Firebird1029/enas344-final/(list of files, cad)

Other CAD files:
box/final_cardboard_box.dwg
