Firebird1029/enas344-final/v2.5/v2.5.ino

#include <Adafruit_GFX.h>
#include <Adafruit_MPU6050.h>
#include <Adafruit_SSD1306.h>
#include <Adafruit_Sensor.h>
#include <Audio.h>
#include <Bounce2.h>
#include <Encoder.h>
#include <SD.h>
#include <SPI.h>
#include <SerialFlash.h>
#include <Wire.h>

// Konrad's custom delay line code
#include "effect_delayLoop.h"

// GENERAL

// 1 measure @ 100 bpm (1 quarter note = 600 ms)
// 1 measure = 4 quarter notes = 4 * 600 ms = 2400 ms
#define LOOP_TIME 2400

// 44100 samples/sec * 10 sec = 441000
// 44100 samples/sec * 3 sec = 132300
// should be as long/longer than LOOP_TIME
#define DELAYLINE_MAX_LEN 132300

#define MASTER_VOLUME 0.5  // <= 0.8 to prevent distortion

// menu encoder sensitivity (how many encoder ticks to change to next menu item)
#define MES 10

#define BASE_FREQ 349.23  // F4, default tonic
// FUTURE: allow option to change tonic

// lower value = faster rate; slower rate prevents value ramping issue
#define RIBBON_POT_CHECK_RATE 5

// default envelope values
#define DEFAULT_ENV_ATTACK 10.5
#define DEFAULT_ENV_HOLD 2.5
#define DEFAULT_ENV_DECAY 35
#define DEFAULT_ENV_SUSTAIN 0.8
#define DEFAULT_ENV_RELEASE 300

#define CHIPTUNE_FREQ_MOD 6.0
#define CHIPTUNE_AMP_PER_SEMITONE (1.f / (CHIPTUNE_FREQ_MOD * 12))
// Explanation: 1 octave has 12 semitones. If amplitude of DC object into FM is
// 1.0, then pitch is 6 octaves higher. So, the amplitude of the DC object to
// get 1 semitone higher should be the above.

// PINOUT

#define ENCODER_DT_PIN 3
#define ENCODER_CLK_PIN 4  // reverse DT & CLK for counterclockwise
#define ENCODER_BTN_PIN 2
#define RIBBON_POT_PIN_1 41  // A17
#define RIBBON_POT_PIN_2 40  // A16
// #define LOOP_BTN_PIN 32
// #define COMMIT_BTN_PIN 31
// #define CLEAR_BTN_PIN 30

// OLED

#define SCREEN_WIDTH 128
#define SCREEN_HEIGHT 32
#define OLED_RESET_PIN -1
#define SCREEN_ADDRESS 0x3C

// MOTION

#define MOTION_ALPHA 0.5  // 0 = acceleration, 1 = gyro, default: 0.995

// use basic_readings_calib to determine IMU calibration values, otherwise
// values will drift

#define ACCELX_OFF 0.295
#define ACCELY_OFF 0.08
#define ACCELZ_OFF -0.2

#define GYROX_OFF -0.1197
#define GYROY_OFF -0.0157
#define GYROZ_OFF -0.0190

#define ACCELX_SCALE 1.008
#define ACCELY_SCALE 1.00
#define ACCELZ_SCALE 0.98

#define GYROX_SCALE 1
#define GYROY_SCALE 1
#define GYROZ_SCALE 1

// AUDIO
EXTMEM int16_t DELAY_LINE_TEMP[DELAYLINE_MAX_LEN] = {};
EXTMEM int16_t DELAY_LINE_FULL_1[DELAYLINE_MAX_LEN] = {};
EXTMEM int16_t DELAY_LINE_FULL_2[DELAYLINE_MAX_LEN] = {};
EXTMEM int16_t DELAY_LINE_FULL_3[DELAYLINE_MAX_LEN] = {};
EXTMEM int16_t DELAY_LINE_FULL_4[DELAYLINE_MAX_LEN] = {};

// CUSTOM GUItool OVERRIDES
AudioEffectdelayLoop tempDelay;   // xy=607,182
AudioEffectdelayLoop fullDelay1;  // xy=868,201
AudioEffectdelayLoop fullDelay2;  // xy=868,201
AudioEffectdelayLoop fullDelay3;  // xy=868,201
AudioEffectdelayLoop fullDelay4;  // xy=868,201

// use pjrc.txt to get/store original (unformatted) GUItool auto-generated code

// GUItool: begin automatically generated code
AudioSynthWaveformDc chipDC;                // xy=55.5,583
AudioPlaySdRaw sdDrum1;                     // xy=58.5,701
AudioPlaySdRaw sdDrum2;                     // xy=58.5,738
AudioSynthWaveform chord2fm;                // xy=59.5,499
AudioPlaySdRaw sdDrum3;                     // xy=58.5,776
AudioSynthWaveform chord3fm;                // xy=60.5,539
AudioSynthSimpleDrum drumSynth;             // xy=64.5,661
AudioSynthWaveform inWaveformFM;            // xy=77.5,401
AudioSynthWaveformDc inRamp;                // xy=120.5,298
AudioSynthWaveformModulated inWaveformMod;  // xy=191.5,452
AudioSynthWaveformModulated chipWave;       // xy=196.5,590
AudioSynthWaveformModulated chord3wave;     // xy=201.5,545
AudioSynthWaveformModulated chord2wave;     // xy=205.5,506
AudioMixer4 modeSelect;                     // xy=219.5,80
AudioEffectMultiply multiply1;              // xy=252.5,325
AudioMixer4 drumMixer;                      // xy=314.5,715
AudioMixer4 inMixer;                        // xy=335.5,177
AudioEffectEnvelope chipEnv;                // xy=335.5,590
AudioEffectEnvelope chord3env;              // xy=351.5,545
AudioSynthSimpleDrum metronome;             // xy=354.5,28
AudioEffectEnvelope chord2env;              // xy=353.5,506
AudioSynthSimpleDrum notification;          // xy=364.5,65
AudioEffectEnvelope inEnvelope;             // xy=363.5,453
AudioMixer4 tempDelayMixer;                 // xy=457.5,302
AudioMixer4 overlayMixer;                   // xy=519.5,54
AudioMixer4 chordMixer;                     // xy=528.5,502
// AudioEffectDelay         tempDelay;      //xy=607.5,182
AudioAmplifier fullDelay2Amp;              // xy=672.5,352
AudioAmplifier fullDelay1Amp;              // xy=678.5,286
AudioSynthWaveformSine outLadderFreqSine;  // xy=681.5,89
AudioMixer4 outMixer;                      // xy=712.5,35
AudioAmplifier fullDelay4Amp;              // xy=715.5,596
AudioAmplifier fullDelay3Amp;              // xy=722.5,466
AudioSynthWaveformDc fullRamp;             // xy=773.5,134
AudioMixer4 fullDelay1Mixer;               // xy=847.5,292
AudioMixer4 fullDelay2Mixer;               // xy=849.5,363
AudioMixer4 fullDelay3Mixer;               // xy=852.5,522
AudioMixer4 fullDelay4Mixer;               // xy=853.5,648
AudioFilterLadder outLadder;               // xy=880.5,30
AudioEffectMultiply multiply2;             // xy=892.5,167
AudioAmplifier outAmp;                     // xy=997.5,75
// AudioEffectDelay         fullDelay1;     //xy=1000.5,292
// AudioEffectDelay         fullDelay2;     //xy=1000.5,420
// AudioEffectDelay         fullDelay3;     //xy=1000.5,549
// AudioEffectDelay         fullDelay4;     //xy=1001.5,677
AudioMixer4 delaySelectNew;               // xy=1076.5,161
AudioOutputI2S i2s1;                      // xy=1120.5,31
AudioSynthWaveformDc delaySelectOldRamp;  // xy=1177,337
AudioSynthWaveformDc delaySelectNewRamp;  // xy=1187,246
AudioEffectMultiply multiply3;            // xy=1275,287
AudioEffectMultiply multiply4;            // xy=1278,369
AudioMixer4 delaySelectOld;               // xy=1294,444
AudioMixer4 delayOutMixer;                // xy=1308,165
AudioConnection patchCord1(chipDC, 0, chipWave, 0);
AudioConnection patchCord2(sdDrum1, 0, drumMixer, 1);
AudioConnection patchCord3(sdDrum2, 0, drumMixer, 2);
AudioConnection patchCord4(chord2fm, 0, chord2wave, 0);
AudioConnection patchCord5(sdDrum3, 0, drumMixer, 3);
AudioConnection patchCord6(chord3fm, 0, chord3wave, 0);
AudioConnection patchCord7(drumSynth, 0, drumMixer, 0);
AudioConnection patchCord8(inWaveformFM, 0, inWaveformMod, 0);
AudioConnection patchCord9(inRamp, 0, multiply1, 0);
AudioConnection patchCord10(inWaveformMod, inEnvelope);
AudioConnection patchCord11(chipWave, chipEnv);
AudioConnection patchCord12(chord3wave, chord3env);
AudioConnection patchCord13(chord2wave, chord2env);
AudioConnection patchCord14(modeSelect, 0, inMixer, 0);
AudioConnection patchCord15(multiply1, 0, tempDelayMixer, 1);
AudioConnection patchCord16(drumMixer, 0, modeSelect, 3);
AudioConnection patchCord17(drumMixer, 0, inMixer, 1);
AudioConnection patchCord18(inMixer, 0, outMixer, 0);
AudioConnection patchCord19(inMixer, 0, multiply1, 1);
AudioConnection patchCord20(chipEnv, 0, modeSelect, 1);
AudioConnection patchCord21(chord3env, 0, chordMixer, 2);
AudioConnection patchCord22(metronome, 0, overlayMixer, 0);
AudioConnection patchCord23(chord2env, 0, chordMixer, 1);
AudioConnection patchCord24(notification, 0, overlayMixer, 1);
AudioConnection patchCord25(inEnvelope, 0, modeSelect, 0);
AudioConnection patchCord26(inEnvelope, 0, chordMixer, 0);
AudioConnection patchCord27(tempDelayMixer, tempDelay);
AudioConnection patchCord28(overlayMixer, 0, outMixer, 3);
AudioConnection patchCord29(chordMixer, 0, modeSelect, 2);
AudioConnection patchCord30(tempDelay, 0, tempDelayMixer, 0);
AudioConnection patchCord31(tempDelay, 0, outMixer, 2);
AudioConnection patchCord32(tempDelay, 0, multiply2, 1);
AudioConnection patchCord33(fullDelay2Amp, 0, fullDelay2Mixer, 1);
AudioConnection patchCord34(fullDelay1Amp, 0, fullDelay1Mixer, 1);
AudioConnection patchCord35(outLadderFreqSine, 0, outLadder, 1);
AudioConnection patchCord36(outMixer, 0, outLadder, 0);
AudioConnection patchCord37(fullDelay4Amp, 0, fullDelay4Mixer, 1);
AudioConnection patchCord38(fullDelay3Amp, 0, fullDelay3Mixer, 1);
AudioConnection patchCord39(fullRamp, 0, multiply2, 0);
AudioConnection patchCord40(fullDelay1Mixer, fullDelay1);
AudioConnection patchCord41(fullDelay2Mixer, fullDelay2);
AudioConnection patchCord42(fullDelay3Mixer, fullDelay3);
AudioConnection patchCord43(fullDelay4Mixer, fullDelay4);
AudioConnection patchCord44(outLadder, outAmp);
AudioConnection patchCord45(multiply2, fullDelay1Amp);
AudioConnection patchCord46(multiply2, fullDelay2Amp);
AudioConnection patchCord47(multiply2, fullDelay3Amp);
AudioConnection patchCord48(multiply2, fullDelay4Amp);
AudioConnection patchCord49(outAmp, 0, i2s1, 0);
AudioConnection patchCord50(outAmp, 0, i2s1, 1);
AudioConnection patchCord51(fullDelay1, 0, fullDelay1Mixer, 0);
AudioConnection patchCord52(fullDelay1, 0, delaySelectNew, 0);
AudioConnection patchCord53(fullDelay1, 0, delaySelectOld, 0);
AudioConnection patchCord54(fullDelay2, 0, fullDelay2Mixer, 0);
AudioConnection patchCord55(fullDelay2, 0, delaySelectNew, 1);
AudioConnection patchCord56(fullDelay2, 0, delaySelectOld, 1);
AudioConnection patchCord57(fullDelay3, 0, fullDelay3Mixer, 0);
AudioConnection patchCord58(fullDelay3, 0, delaySelectNew, 2);
AudioConnection patchCord59(fullDelay3, 0, delaySelectOld, 2);
AudioConnection patchCord60(fullDelay4, 0, fullDelay4Mixer, 0);
AudioConnection patchCord61(fullDelay4, 0, delaySelectNew, 3);
AudioConnection patchCord62(fullDelay4, 0, delaySelectOld, 3);
AudioConnection patchCord63(delaySelectNew, 0, multiply3, 1);
AudioConnection patchCord64(delaySelectOldRamp, 0, multiply4, 0);
AudioConnection patchCord65(delaySelectNewRamp, 0, multiply3, 0);
AudioConnection patchCord66(multiply3, 0, delayOutMixer, 0);
AudioConnection patchCord67(multiply4, 0, delayOutMixer, 1);
AudioConnection patchCord68(delaySelectOld, 0, multiply4, 1);
AudioConnection patchCord69(delayOutMixer, 0, outMixer, 1);
AudioControlSGTL5000 sgtl5000_1;  // xy=64.5,20
// GUItool: end automatically generated code

// BUTTONS
// Button loopButton = Button();
Button encButton = Button();

// ENCODER
Encoder enc(ENCODER_DT_PIN, ENCODER_CLK_PIN);

// MPU6050 IMU
Adafruit_MPU6050 mpu;

// OLED
Adafruit_SSD1306 display(SCREEN_WIDTH, SCREEN_HEIGHT, &Wire, OLED_RESET_PIN);

// GLOBAL - MOTION

float accelx, accely, accelz, gyrox, gyroy, gyroz = 0;

float accelPitch;  // about y
float accelRoll;   // about x

float gyroPitch = 0;  // about y
float gyroRoll = 0;   // about x
float gyroYaw = 0;    // about z

float pitchDot = 0;
float rollDot = 0;
float yawDot = 0;

float pitch = 0;
float roll = 0;
float yaw = 0;

// GLOBAL - AUDIO

int baseFreq = BASE_FREQ;
int metronomeSpeed = 0;  // 0 = off, 1 = tick at quarter note rate, 2 = tick at
                         // eighth note rate, 3 = tick at triplet rate, etc.

const int majorScale[8] = {0, 2, 4, 5, 7, 9, 11, 12};
const int minorScale[8] = {0, 2, 3, 5, 7, 8, 10, 12};
const int pentatonicScale[6] = {0, 2, 4, 7, 9, 12};
enum SCALE_TYPE { MAJOR, MINOR, PENTATONIC, CHROMATIC };
// FUTURE: allow option to change scale type

// percussion samples on SD card
const char *SD_PERC[] = {"00_kick2.raw",      "01_snare.raw",
                         "02_tom_low.raw",    "04_tom_high.raw",
                         "05_hihat_open.raw", "06_hihat_closed.raw",
                         "07_rim.raw",        "08_shaker.raw"};

// Chiptune
#define ARPEGGIO_COUNT 1
#define ARPEGGIO_SPEED 50  // ms between arpeggio notes
int ARPEGGIO_LENGTHS[ARPEGGIO_COUNT] = {12};
int ARPEGGIO_1[] = {0, 7, 12, 19, 24, 31, 36, 31, 24, 19, 12, 7};  // 5th + 8va
int *ARPEGGIOS[ARPEGGIO_COUNT] = {ARPEGGIO_1};

int currentArpeggio = 0, curArpNoteIdx = 0;
long unsigned int nextArpNoteTime = 0;

// GLOBAL - GENERAL

elapsedMillis timer;  // master timer (auto-incrementing)

// pitch changes orientation, roll changes rollState
// home = OLED + encoder, playing = softpot, other = opposite of OLED + encoder
enum ORIENTATION { HOME, PLAYING, OTHER };  // pitch (towards/away) orientation
ORIENTATION orientation = HOME;
ORIENTATION lastOrientation = HOME;

enum ROLL_STATE {  // roll (sideways) orientation
  FLAT,
  LEFT,
  LEFT_START_TRIGGER,
  LEFT_END_TRIGGER,
  RIGHT,
  RIGHT_START_TRIGGER,
  RIGHT_END_TRIGGER
};
ROLL_STATE rollState = FLAT;
ROLL_STATE lastRollState = FLAT;

bool looperOn = false;  // true = loop automatically on playing position
int activeLoop = 0;     // -1 = no loop active, 0-3 = loop index
enum RECORDING_STATE {  // status of the delay line recording process
  READY_FOR_RECORD,
  RECORDING,
  READY_FOR_COMMIT,
  COMMITTING
};
RECORDING_STATE recordingState = READY_FOR_RECORD;

long unsigned int lastCheckedRibbonPot = 0,  // last time ribbon pot was checked
    lastMetronomeTick = 0,                   // last time metronome ticked
    tempRecordingStart =
        0,  // timestamp when recording started (recording into temp delay)
    commitRecordingStart =
        0;  // timestamp when commit started (recording into full delay)

int mappedRibbonPotVal =
    0;  // ribbon softpot values mapped to integer half-tones above fundamental

// curSustainStatus == 0 && ribbon released -> do nothing
// curSustainStatus == 0 && ribbon pressed -> note on, set status := 1
// curSustainStatus == 1 && ribbon pressed -> sustain note
// curSustainStatus == 1 && ribbon released -> note off, set status := 0
bool curSustainStatus = false;

// GLOBAL - MENU (OLED + ENCODER)

// Warning: Make sure all 5 variables match!
#define NUM_MODE_OPTIONS 5
const char *MODE_OPTIONS[NUM_MODE_OPTIONS] = {"Simple", "Soft", "Chiptune",
                                              "Chord", "Percussion"};
enum MODE_STATE {
  MODE_SIMPLE = 0,
  MODE_SOFT,
  MODE_CHIPTUNE,
  MODE_CHORD,
  MODE_PERCUSSION
};
MODE_STATE currentSoundMode = MODE_SIMPLE;

enum MENU_STATE {
  MENU_MODE,
  MENU_VOLUME,
  MENU_CLEAR,
  MENU_METRONOME,
  MENU_LOOPER
};
MENU_STATE menuState = MENU_MODE;
// on OLED, > = menu inactive, >> = menu active
enum MENU_ACTIVE { MENU_INACTIVE, MENU_ACTIVE_OPTION };
MENU_ACTIVE menuActiveState = MENU_INACTIVE;

int clientMasterVolume = 100,  // 0-100
    encValue,                  // current encoder value
    savedEncValueMenu,  // encValue of main menu (before entering active option)
    savedEncValueHome;  // encValue of menu (both main menu and active submenu)
                        // before switching to playing mode

void setup(void) {
  // SERIAL SETUP
  Serial.begin(115200);
  Serial.println("Serial started");

  // AUDIO SETUP
  AudioMemory(500);
  sgtl5000_1.enable();
  sgtl5000_1.volume(MASTER_VOLUME);

  // Basic Synth
  inWaveformFM.begin(0.0, 6, WAVEFORM_SINE);
  inWaveformMod.begin(0.5, baseFreq, WAVEFORM_SAWTOOTH);
  inWaveformMod.frequencyModulation(1);
  inEnvelope.attack(DEFAULT_ENV_ATTACK);
  inEnvelope.hold(DEFAULT_ENV_HOLD);
  inEnvelope.decay(DEFAULT_ENV_DECAY);
  inEnvelope.sustain(DEFAULT_ENV_SUSTAIN);
  inEnvelope.release(DEFAULT_ENV_RELEASE);

  // Chiptune
  chipDC.amplitude(0);
  chipWave.begin(0.25, baseFreq, WAVEFORM_BANDLIMIT_SQUARE);
  chipWave.frequencyModulation(CHIPTUNE_FREQ_MOD);
  chipEnv.attack(DEFAULT_ENV_ATTACK);
  chipEnv.hold(DEFAULT_ENV_HOLD);
  chipEnv.decay(DEFAULT_ENV_DECAY);
  chipEnv.sustain(DEFAULT_ENV_SUSTAIN);
  chipEnv.release(DEFAULT_ENV_RELEASE);

  // Chords -- copy & paste from Basic Synth
  chord2fm.begin(0.0, 6, WAVEFORM_SINE);
  chord2wave.begin(0.5, baseFreq, WAVEFORM_SINE);
  chord2wave.frequencyModulation(1);
  chord2env.attack(DEFAULT_ENV_ATTACK);
  chord2env.hold(DEFAULT_ENV_HOLD);
  chord2env.decay(DEFAULT_ENV_DECAY);
  chord2env.sustain(DEFAULT_ENV_SUSTAIN);
  chord2env.release(DEFAULT_ENV_RELEASE);

  chord3fm.begin(0.0, 6, WAVEFORM_SINE);
  chord3wave.begin(0.5, baseFreq, WAVEFORM_SINE);
  chord3wave.frequencyModulation(1);
  chord3env.attack(DEFAULT_ENV_ATTACK);
  chord3env.hold(DEFAULT_ENV_HOLD);
  chord3env.decay(DEFAULT_ENV_DECAY);
  chord3env.sustain(DEFAULT_ENV_SUSTAIN);
  chord3env.release(DEFAULT_ENV_RELEASE);

  chordMixer.gain(0, 1.0);
  chordMixer.gain(1, 1.0);
  chordMixer.gain(2, 1.0);

  // Percussion
  drumSynth.frequency(60);
  drumSynth.length(1500);
  drumSynth.secondMix(0.0);
  drumSynth.pitchMod(0.55);
  drumMixer.gain(0, 0.5);  // drum synth
  drumMixer.gain(1, 0.8);  // sd sample reader 1
  // ! using more than one sd read is buggy so sdDrum2 and sdDrum3 are unused
  drumMixer.gain(2, 0.0);  // sd sample reader 2
  drumMixer.gain(3, 0.0);  // sd sample reader 3

  // Overlay Sounds (Metronome + Notification)
  // notification plays sound effect when changing octave, discarding loop
  metronome.frequency(4000);
  metronome.length(50);
  metronome.secondMix(0.0);
  metronome.pitchMod(0.5);
  notification.frequency(5000);
  notification.length(100);
  notification.secondMix(0.0);
  notification.pitchMod(0.5);
  overlayMixer.gain(0, 1.0);  // metronome
  overlayMixer.gain(1, 1.0);  // notification

  // Mode Selection
  modeSelect.gain(0, 1.0);  // simple/soft
  modeSelect.gain(1, 0.0);  // chiptune
  modeSelect.gain(2, 0.0);  // chord
  modeSelect.gain(3, 0.0);  // percussion
  inMixer.gain(0, 0.8);     // mode output
  inMixer.gain(1, 0.8);     // drum synth

  // Delay Lines - Amps & Mixers Only
  tempDelayMixer.gain(0, 0.0);   // feedback
  tempDelayMixer.gain(1, 0.0);   // inMixer
  fullDelay1Mixer.gain(0, 1.0);  // feedback
  fullDelay1Mixer.gain(1, 1.0);  // temp mixer
  fullDelay1Amp.gain(1.0);       // enable full delay 1 by default
  delaySelectNew.gain(0, 1.0);   // enable full delay 1 by default
  delaySelectNewRamp.amplitude(1.0);
  delayOutMixer.gain(0, 1.0);  // delaySelectNewRamp
  delayOutMixer.gain(1, 1.0);  // delaySelectOldRamp

  // using a for loop for these does not work!
  fullDelay2Amp.gain(0.0);
  fullDelay3Amp.gain(0.0);
  fullDelay4Amp.gain(0.0);
  fullDelay2Mixer.gain(0, 1.0);  // full delay 2 feedback
  fullDelay3Mixer.gain(0, 1.0);  // full delay 3 feedback
  fullDelay4Mixer.gain(0, 1.0);  // full delay 4 feedback
  fullDelay2Mixer.gain(1, 1.0);  // full delay 2 temp mixer
  fullDelay3Mixer.gain(1, 1.0);  // full delay 3 temp mixer
  fullDelay4Mixer.gain(1, 1.0);  // full delay 4 temp mixer
  for (int i = 1; i < 4; i++) {
    delaySelectNew.gain(i, 0.0);  // disable full delay i output sound
    delaySelectOld.gain(i, 0.0);  // disable full delay i output sound
  }
  // disable full delay 1 as well because for loop goes from 1-4
  delaySelectOld.gain(0, 0.0);
  delaySelectOldRamp.amplitude(0.0);

  // Amplitude Ramping
  // smoothes out waveform into delay line to prevent popping sound, but over
  // time there will be a "dent" there in the full delay line
  inRamp.amplitude(0.0);
  fullRamp.amplitude(0.0);

  // Output
  outMixer.gain(0, 1.0);  // realtime dry input
  outMixer.gain(1,
                0.0);  // full delay -- set to 0.0 to avoid initial random noise
  outMixer.gain(2,
                0.0);  // temp delay -- set to 0.0 to avoid initial random noise
  outMixer.gain(3, 1.0);            // overlay sounds
  outLadderFreqSine.frequency(10);  // unused
  outLadderFreqSine.amplitude(0);
  outLadder.frequency(100000);  // unused
  outLadder.octaveControl(6);
  outAmp.gain(1.0);

  // BUTTON SETUP
  // loopButton.attach(LOOP_BTN_PIN, INPUT_PULLUP);
  // loopButton.interval(5);
  // loopButton.setPressedState(LOW);

  // ENCODER SETUP
  encButton.attach(ENCODER_BTN_PIN, INPUT_PULLUP);
  encButton.interval(5);
  encButton.setPressedState(LOW);

  // MOTION SETUP
  Serial.println("Initializing MPU6050...");
  if (!mpu.begin()) {
    Serial.println("ERROR: Failed to find MPU6050 chip!");
    while (true) {
      delay(10);
    }
  }
  Serial.println("Initialized MPU6050!");

  mpu.setAccelerometerRange(MPU6050_RANGE_2_G);
  mpu.setGyroRange(MPU6050_RANGE_500_DEG);
  mpu.setFilterBandwidth(MPU6050_BAND_184_HZ);

  // OLED SETUP
  if (!display.begin(SSD1306_SWITCHCAPVCC, SCREEN_ADDRESS)) {
    Serial.println(F("SSD1306 allocation failed"));
    while (true) {
      delay(10);
    }
  }
  display.display();
  delay(500);
  display.clearDisplay();
  display.setTextColor(SSD1306_WHITE);
  display.setTextSize(1);

  // SD SETUP
  // uses SD port on Teensy 4.1, NOT the SD reader on audio shield
  if (!SD.begin(BUILTIN_SDCARD)) {
    Serial.println("Unable to access SD Card");
    while (true) {
      delay(10);
    }
  }

  // DELAY LINES
  tempDelay.begin(DELAY_LINE_TEMP, DELAYLINE_MAX_LEN);
  fullDelay1.begin(DELAY_LINE_FULL_1, DELAYLINE_MAX_LEN);
  fullDelay2.begin(DELAY_LINE_FULL_2, DELAYLINE_MAX_LEN);
  fullDelay3.begin(DELAY_LINE_FULL_3, DELAYLINE_MAX_LEN);
  fullDelay4.begin(DELAY_LINE_FULL_4, DELAYLINE_MAX_LEN);
  tempDelay.delay(0, LOOP_TIME);   // must come after tempDelay.begin!
  fullDelay1.delay(0, LOOP_TIME);  // must come after fullDelay1.begin!
  fullDelay2.delay(0, LOOP_TIME);  // etc.
  fullDelay3.delay(0, LOOP_TIME);
  fullDelay4.delay(0, LOOP_TIME);

  // clear delay lines -- avoid initial random noise
  // for loop (theoretically) helps ensure delay line is fully cleared
  for (int i = 0; i < 3; i++) {
    tempDelay.clear();
    fullDelay1.clear();
    fullDelay2.clear();
    fullDelay3.clear();
    fullDelay4.clear();
  }

  Serial.println("Finished setup.");
  delay(100);
}

void loop() {
  // MOTION CODE -- Read motion data
  // This comes first to determine orientation
  motionCode();

  // MODE SELECTION
  // must come before RIBBON POT (PITCH) code!
  modeSelectionCode();

  // RIBBON POT (PITCH)
  ribbonPotCode();

  // Read button data
  // loopButton.update();

  // LOOP RECORDING
  loopRecordingCode();

  // METRONOME
  metronomeCode();

  // MENU & SOUND EFFECTS
  // encoder scrolls through menu in HOME orientation, and (in the future) goes
  // through sound modulation options in PLAYING orientation
  encValue = enc.read();
  encButton.update();

  if (orientation == HOME) {
    if (lastOrientation == PLAYING) {
      Serial.println("Playing -> Home");
      // restore old encoder value
      encValue = savedEncValueHome;
      enc.write(savedEncValueHome);
      lastOrientation = HOME;
    }

    menuCode();
  } else if (orientation == PLAYING) {
    if (lastOrientation == HOME) {
      Serial.println("Home -> Playing");
      // save encoder value
      savedEncValueHome = encValue;
      enc.write(0);

      // reset base octave
      baseFreq = BASE_FREQ;

      lastOrientation = PLAYING;
    }

    soundEffectsCode();
  }

  // SET LOOP OR OCTAVES
  if (orientation == HOME) {
    if (rollState == LEFT_END_TRIGGER && recordingState == READY_FOR_RECORD) {
      // Change Master Full Delay Loop
      // change loop only when finished committing
      setActiveLoop((activeLoop + 3) % 4, activeLoop);
      // ping(500, 0.5);
    } else if (rollState == RIGHT_END_TRIGGER &&
               recordingState == READY_FOR_RECORD) {
      setActiveLoop((activeLoop + 1) % 4, activeLoop);
      // ping(500, 0.5);
    }
  } else if (orientation == PLAYING) {
    // Change Octaves
    if (rollState == LEFT_END_TRIGGER) {
      baseFreq /= 2;  // go down an octave
      ping(500, 0.6);
    } else if (rollState == RIGHT_END_TRIGGER) {
      baseFreq *= 2;  // go up an octave
      ping(500, 0.4);
    }
  }

  // FUTURE: QUICK PERCUSSION
  // disabled because a light tap triggers high acceleration
  if (abs(accelz) > 19.0 && orientation == PLAYING) {
    // a shake up/down usually goes up to 19.0
    // FUTURE: change to change in acceleration
    // Serial.println(accelz);
    // drumSynth.noteOn();
    // if (!sdDrum1.isPlaying()) {
    //   sdDrum1.play(SD_PERC[0]);
    // }
  }

  delay(1);
}

// MOTION CODE

void motionCode() {
  // Professor Wilen's code
  sensors_event_t a, g, temp;
  mpu.getEvent(&a, &g, &temp);

  accelx = -(a.acceleration.x - ACCELX_OFF) / ACCELX_SCALE;
  accely = -(a.acceleration.y - ACCELY_OFF) / ACCELY_SCALE;
  accelz = -(a.acceleration.z - ACCELZ_OFF) / ACCELZ_SCALE;

  gyrox = (g.gyro.x - GYROX_OFF);
  gyroy = (g.gyro.y - GYROY_OFF);
  gyroz = (g.gyro.z - GYROZ_OFF);

  pitchDot = gyroy * cos(roll) - gyroz * sin(roll);
  yawDot = (gyroy * sin(roll) + gyroz * cos(roll)) / cos(pitch);
  rollDot = gyrox + sin(pitch) * yawDot;

  // gyroPitch = gyroPitch + gyroy * 0.01;
  // gyroRoll =  gyroRoll + gyrox * 0.01;
  // gyroYaw =  gyroYaw + gyroz * 0.01;

  accelPitch = atan2(-accelx, sqrt(accely * accely + accelz * accelz));
  accelRoll = atan2(accely, sqrt(accelx * accelx + accelz * accelz));

  // final pitch value
  // pitch ranges from -1.5 to 1.5
  pitch = MOTION_ALPHA * (pitch + pitchDot * 0.01) +
          (1 - MOTION_ALPHA) * accelPitch;
  // final roll value
  // roll ranges from -0.5 to 0.5
  roll =
      -MOTION_ALPHA * (roll + rollDot * 0.01) - (1 - MOTION_ALPHA) * accelRoll;

  // calculate roll state
  calculateRollState();

  // change orientation state based on pitch, only if no roll
  if (abs(roll) < 0.1) {
    if (abs(pitch) < 0.3) {
      orientation = PLAYING;
    } else if (pitch < -1.2) {
      orientation = HOME;
    } else if (pitch > 1.2) {
      orientation = OTHER;
    }
  }
}

void calculateRollState() {
  // state machine for roll
  switch (rollState) {
    case FLAT:
      if (roll > 0.4) {
        rollState = LEFT_START_TRIGGER;
      } else if (roll < -0.4) {
        rollState = RIGHT_START_TRIGGER;
      }
      break;
    case LEFT_START_TRIGGER:
      // FUTURE: add a delay to these 2 start triggers
      if (roll > 0.4) {
        rollState = LEFT;
      } else {
        rollState = FLAT;
      }
      break;
    case RIGHT_START_TRIGGER:
      if (roll < -0.4) {
        rollState = RIGHT;
      } else {
        rollState = FLAT;
      }
      break;
    case LEFT:
      if (roll <= 0.1) {
        rollState = LEFT_END_TRIGGER;
      }
      break;
    case RIGHT:
      if (roll >= -0.1) {
        rollState = RIGHT_END_TRIGGER;
      }
      break;
    case LEFT_END_TRIGGER:
    case RIGHT_END_TRIGGER:
      rollState = FLAT;
      break;
  }
}

// RIBBON POT CODE
const int minorSemiTonesUp[] = {3, 3, 4, 3, 3, 4, 4, 3};
// e.g. in a minor scale, the 3rd is 3 semitones up from the 1st note, but 4
// semitones up from the 3rd note
// FUTURE: map semitones for major scale
void ribbonPotCode() {
  // only check ribbon pot for updates as fast as RIBBON_POT_CHECK_RATE
  if (timer >= lastCheckedRibbonPot + RIBBON_POT_CHECK_RATE) {
    lastCheckedRibbonPot = timer;

    mappedRibbonPotVal = getRibbonPotValAndMap(0, 8);
    // FUTURE change to (0, 6) for pentatonic scale, adjust accordingly

    if (mappedRibbonPotVal > -1) {
      // ribbon pressed if > -1

      // set frequencies in pitched modes
      if (currentSoundMode != MODE_PERCUSSION) {
        int origPotVal = mappedRibbonPotVal;

        // FUTURE: allow option to change scale type
        mappedRibbonPotVal = mapScale(MINOR, mappedRibbonPotVal);

        // set frequencies for each oscillator in every sound mode
        // (but only output the currently active mode)
        inWaveformMod.frequency(baseFreq * pow(2, mappedRibbonPotVal / 12.0));
        chipWave.frequency(baseFreq * pow(2, mappedRibbonPotVal / 12.0));

        // 2nd note of triad depends on scale degree in diatonic scales
        chord2wave.frequency(
            baseFreq *
            pow(2, (mappedRibbonPotVal + minorSemiTonesUp[origPotVal]) / 12.0));

        // 3rd note of triad is always 5th above
        chord3wave.frequency(baseFreq *
                             pow(2, (mappedRibbonPotVal + 7) / 12.0));
      }

      if (curSustainStatus) {
        // sustain note, do nothing
      } else {
        // note on
        inEnvelope.noteOn();
        chipEnv.noteOn();
        chord2env.noteOn();
        chord3env.noteOn();

        // percussion mode
        if (currentSoundMode == MODE_PERCUSSION) {
          mapPercussion(mappedRibbonPotVal);
        }

        curSustainStatus = true;
      }
    } else {
      if (curSustainStatus) {
        // note off
        inEnvelope.noteOff();
        chipEnv.noteOff();
        chord2env.noteOff();
        chord3env.noteOff();
        curSustainStatus = false;
      }
    }
  }
}

/**
 * @brief get the ribbon pot val and map it to a new range if being pressed
 *
 * @param newMin min of new range, output will never be less than this
 * @param newMax max of new range, output will never be more than this
 * @return (int) -1 if ribbon pot is not pressed, otherwise a value between
 * newMin and newMax
 */
int getRibbonPotValAndMap(int newMin, int newMax) {
  float a1 = analogRead(RIBBON_POT_PIN_1);
  float a2 = analogRead(RIBBON_POT_PIN_2);

  if (a1 < 10 || a2 < 10) {
    return -1;  // ribbon pot not pressed
  }

  // calibrate by measuring actual resistance of 10k resistor
  // (e.g. 9.78 or 9.81)
  float x = ((1023 / (float)a1) - 1) * (10 / 9.78);
  float y = ((1023 / (float)a2) - 1) * (10 / 9.81);

  float pos = (x + (1 - y)) / 2;  // normalized position (from 0.0 to 1.0)

  pos = (newMax - newMin) * pos + newMin;  // mapped position

  // clip position
  if (pos < newMin) {
    pos = newMin;
  } else if (pos > newMax) {
    pos = newMax;
  }

  return (int)pos;
}

int mapScale(SCALE_TYPE scaleType, int step) {
  if (step == -1) {
    return -1;
  }
  if (scaleType == MAJOR) {
    // convert step (from 0-6 inclusive) to a major scale
    return majorScale[step];
  } else if (scaleType == MINOR) {
    // convert step (from 0-6 inclusive) to a minor scale
    return minorScale[step];
  } else if (scaleType == PENTATONIC) {
    // convert step (from 0-5 inclusive) to a pentatonic scale
    return pentatonicScale[step];
  }

  return step;
}

void mapPercussion(int sampleNum) {
  if (sampleNum < 0 || sampleNum > 7) {
    return;
  }

  // ! using more than one sd read is buggy so sdDrum2 and sdDrum3 are unused
  // FUTURE: add drumSynth along with sdDrum1

  switch (sampleNum) {
    case 0:
      sdDrum1.play(SD_PERC[0]);
      break;
    case 1:
      sdDrum1.play(SD_PERC[1]);
      break;
    case 2:
      sdDrum1.play(SD_PERC[2]);
      break;
    case 3:
      sdDrum1.play(SD_PERC[3]);
      break;
    case 4:
      sdDrum1.play(SD_PERC[4]);
      break;
    case 5:
      sdDrum1.play(SD_PERC[5]);
      break;
    case 6:
      sdDrum1.play(SD_PERC[6]);
      break;
    case 7:
      sdDrum1.play(SD_PERC[7]);
      break;
  }

  // 3 different SD read objects to enable percussive polyphony

  // doesn't work :(

  // if (!sdDrum1.isPlaying()) {
  //   sdDrum1.play(SD_PERC[mappedRibbonPotVal]);
  // } else if (!sdDrum2.isPlaying()) {
  //   sdDrum2.play(SD_PERC[mappedRibbonPotVal]);
  // }
  // else if (!sdDrum3.isPlaying()) {
  //   sdDrum3.play(SD_PERC[mappedRibbonPotVal]);
  // }
}

// CHIPTUNE CODE

void chiptuneCode() {
  if (timer >= nextArpNoteTime + ARPEGGIO_SPEED) {
    nextArpNoteTime = timer;

    chipDC.amplitude(
        ARPEGGIOS[currentArpeggio][curArpNoteIdx] * CHIPTUNE_AMP_PER_SEMITONE,
        0);
    curArpNoteIdx++;
    if (curArpNoteIdx >= ARPEGGIO_LENGTHS[currentArpeggio]) {
      curArpNoteIdx = 0;
    }
  }
}

// METRONOME CODE

void metronomeCode() {
  if (metronomeSpeed > 0) {
    if (timer >= lastMetronomeTick + (LOOP_TIME / (metronomeSpeed * 4))) {
      if (timer <
          (lastMetronomeTick + 2 * (LOOP_TIME / (metronomeSpeed * 4)))) {
        // reduces metronome drift by ignoring drift of most recent tick
        lastMetronomeTick =
            lastMetronomeTick + (LOOP_TIME / (metronomeSpeed * 4));
      } else {
        // however, if metronome has been turned off, then start metronome
        // from current time
        lastMetronomeTick = timer;
      }

      metronome.noteOn();
    }
  }
}

// MODE SELECTION CODE

void modeSelectionCode() {
  // disable all input channels initially
  for (int i = 0; i < 4; i++) {
    modeSelect.gain(i, 0.0);
  }

  // Simple
  if (currentSoundMode == MODE_SIMPLE) {
    inWaveformMod.begin(WAVEFORM_SQUARE);
    inWaveformMod.amplitude(0.5);
    modeSelect.gain(0, 1.0);
  }

  // Soft
  if (currentSoundMode == MODE_SOFT) {
    inWaveformMod.begin(WAVEFORM_SINE);
    inWaveformMod.amplitude(0.5);
    modeSelect.gain(0, 1.0);
  }

  // Chiptune
  if (currentSoundMode == MODE_CHIPTUNE) {
    chiptuneCode();
    modeSelect.gain(1, 1.0);
  }

  // Chord
  if (currentSoundMode == MODE_CHORD) {
    inWaveformMod.begin(WAVEFORM_SINE);
    inWaveformMod.amplitude(0.33 / 2);
    chord2wave.amplitude(0.33 / 2);
    chord3wave.amplitude(0.33 / 2);
    modeSelect.gain(2, 1.0);

  } else {
    chord2env.noteOff();
    chord3env.noteOff();
    // do not: chord2/3wave.amplitude(0.0); ! (prevents envelope from releasing)
  }

  // Percussion
  if (currentSoundMode == MODE_PERCUSSION) {
    inMixer.gain(1, 0.0);  // disable quick percussion
    modeSelect.gain(3, 1.0);
  } else {
    inMixer.gain(1, 1.0);  // enable quick percussion
  }
}

// MENU CODE

void menuCode() {
  // Encoder: Menu Navigation
  if (menuActiveState == MENU_INACTIVE) {
    // encoder toggles through menu options
    // FUTURE: use dynamic code instead of if statements
    if (encValue >= 0 && encValue < MES) {
      menuState = MENU_METRONOME;
    } else if (encValue >= MES && encValue < 2 * MES) {
      menuState = MENU_MODE;
    } else if (encValue >= 2 * MES && encValue < 3 * MES) {
      menuState = MENU_LOOPER;
    } else if (encValue >= 3 * MES && encValue < 4 * MES) {
      menuState = MENU_CLEAR;
    } else if (encValue >= 4 * MES && encValue < 5 * MES) {
      menuState = MENU_VOLUME;
    } else if (encValue < 0) {
      // FUTURE: calculate automatically instead of hard-coding
      enc.write(49);
    } else {
      enc.write(0);
    }
  } else if (menuActiveState == MENU_ACTIVE_OPTION) {
    if (menuState == MENU_MODE) {
      // encoder toggles through mode options
      // FUTURE: remove warning by re-writing code
      if (encValue >= MES) {
        currentSoundMode =
            (MODE_STATE)(currentSoundMode + 1) % NUM_MODE_OPTIONS;
        enc.write(0);
      } else if (encValue <= -MES) {
        currentSoundMode =
            (MODE_STATE)(currentSoundMode + NUM_MODE_OPTIONS - 1) %
            NUM_MODE_OPTIONS;
        enc.write(0);
      }
    } else if (menuState == MENU_LOOPER) {
      // encoder toggles looper on/off
      if (encValue >= MES || encValue <= -MES) {
        looperOn = !looperOn;
        enc.write(0);
      }
    } else if (menuState == MENU_VOLUME) {
      // encoder adjusts volume
      clientMasterVolume += (int)(encValue / (int)(MES / 5));
      if (clientMasterVolume < 0) {
        clientMasterVolume = 0;
      } else if (clientMasterVolume > 100) {
        clientMasterVolume = 100;
      }

      // set volume
      outAmp.gain(clientMasterVolume / 100.0);

      enc.write(0);
    } else if (menuState == MENU_METRONOME) {
      // encoder adjusts metronome speed
      metronomeSpeed = (int)(encValue / (int)(MES));
      if (metronomeSpeed < 0) {
        metronomeSpeed = 0;
        enc.write(0);
      } else if (metronomeSpeed > 6) {
        metronomeSpeed = 6;
        enc.write(MES * 6);
      }
    }
  }

  // Encoder Button: Change Active State
  if (encButton.pressed()) {
    if (menuActiveState == MENU_INACTIVE) {
      // change to active option state

      // special exceptions, substate-less menu options
      if (menuState == MENU_CLEAR) {
        if (menuState == MENU_CLEAR) {
          // for loop reduces chance of uncleared clicks/pops
          for (int i = 0; i < 3; i++) {
            // clear temp delay loop
            tempDelay.clear();

            // clear full delay loop
            switch (activeLoop) {
              case 0:
                fullDelay1.clear();
                break;
              case 1:
                fullDelay2.clear();
                break;
              case 2:
                fullDelay3.clear();
                break;
              case 3:
                fullDelay4.clear();
                break;
            }
          }
        }

      } else {
        // menu options with substate

        savedEncValueMenu = encValue;
        menuActiveState = MENU_ACTIVE_OPTION;

        // reset encoder value
        enc.write(0);

        // special exceptions
        if (menuState == MENU_METRONOME) {
          // set encoder value to current metronome speed
          enc.write(MES * metronomeSpeed);
        }
      }
    } else {
      // change to inactive (main menu) state
      encValue = savedEncValueMenu;
      menuActiveState = MENU_INACTIVE;

      // restore menu navigation scroll position
      enc.write(encValue);
    }
  }

  display.clearDisplay();
  display.setCursor(0, 0);

  // Metronome
  displayMenuPrefix(MENU_METRONOME);
  display.print("Metronome: ");
  if (metronomeSpeed == 0) {
    display.print("Off  ");
  } else {
    display.print(metronomeSpeed);
    display.print("    ");
  }

  // Loop Recording Status
  display.println(recordingState == READY_FOR_RECORD ? " " : "*");

  // Mode
  displayMenuPrefix(MENU_MODE);
  display.println(MODE_OPTIONS[currentSoundMode]);

  // Looper
  displayMenuPrefix(MENU_LOOPER);
  display.print(looperOn ? "L  " : "P  ");

  // Clear Loop
  displayMenuPrefix(MENU_CLEAR);
  display.print("Clear    ");

  // Active Loop
  if (activeLoop == -1) {
    display.println(" ");
  } else {
    display.println(activeLoop);
  }

  // Volume
  displayMenuPrefix(MENU_VOLUME);
  display.print("Volume: ");
  display.println(clientMasterVolume);

  display.display();
}

void displayMenuPrefix(int ms) {
  // on OLED, > = menu option is selected but inactive,
  // >> = menu option is selected and active

  if (menuState == ms) {
    display.print(">");
  } else {
    display.print(" ");
  }
  if (menuState == ms && menuActiveState == MENU_ACTIVE_OPTION) {
    display.print(">");
  } else {
    display.print(" ");
  }
  display.print(" ");
}

// SOUNDS EFFECTS CODE

void soundEffectsCode() {
  // FUTURE
  // VIBRATO
  // inWaveformFM.amplitude(mapFloat(abs(roll), 0, 0.5, 0, 0.1));
}

// LOOP RECORDING CODE

void loopRecordingCode() {
  // START RECORDING
  if (recordingState == READY_FOR_RECORD) {
    // to prevent race conditions, do not allow recording a loop if in the
    // middle of committing a loop
    if (orientation == PLAYING && looperOn) {
      Serial.println("STARTING LOOP RECORDING");

      // send the synth signal into the delay loop
      tempDelayMixer.gain(1, 1.0);
      inRamp.amplitude(1.0, 50);

      // tempDelayMixer.gain(0, 0.0); // prevent loop feedback!
      tempDelayMixer.gain(0, 1.0);  // allow loop feedback (don't clear loop)!

      outMixer.gain(2, 1.0);  // enable temp delay output

      tempRecordingStart = timer;

      // recordingState = RECORDING;
      recordingState = READY_FOR_COMMIT;
    }
  }

  // previously, there was an intermediate recording state that would end after
  // LOOP_TIME which would then automatically move to READY_FOR_COMMIT, and at
  // READY_FOR_COMMIT, the user needed to hit a "commit" physical button to
  // start the commit process

  // FINISH RECORDING
  /* else if (recordingState == RECORDING) {
    if (timer >= (tempRecordingStart + LOOP_TIME)) {
      Serial.println("Recording stopped");
      // turn off the signal into the delay loop
      // tempDelayMixer.gain(1, 0.0);
      inRamp.amplitude(0.0, 50);

      // resets the feedback to 1.0 so the loop repeats indefinitely
      tempDelayMixer.gain(0, 1.0);

      outMixer.gain(2, 1.0);  // enable temp delay output
      recordingState = READY_FOR_COMMIT;
    }
  } */

  // START COMMITTING LAYER
  else if (recordingState == READY_FOR_COMMIT) {
    if (orientation == HOME) {
      Serial.println("SAVE pitch detected, committing recording");

      // if you want to restore RECORDING stage, then remove this code

      // -- FROM FINISH RECORDING STAGE --

      // turn off the signal into the delay loop
      // tempDelayMixer.gain(1, 0.0);
      inRamp.amplitude(0.0, 50);  // turn off signal via ramp, not gate

      // resets the feedback to 1.0 so the loop repeats indefinitely
      // tempDelayMixer.gain(0, 1.0); // already on

      outMixer.gain(2, 1.0);  // enable temp delay output

      // -- END FROM FINISH RECORDING STAGE --

      // enable temp delay signal into full delay
      // fullDelay1Mixer.gain(1, 1.0);
      fullRamp.amplitude(1.0, 50);  // turn on signal via ramp, not gate

      commitRecordingStart = timer;

      recordingState = COMMITTING;
    } else if (orientation == OTHER) {
      Serial.println("DISCARD pitch detected");

      // turn off the signal into the delay loop
      // (unnecessary since you have to orient back to PLAYING position anyway)
      // tempDelayMixer.gain(1, 0.0);
      // inRamp.amplitude(0.0, 50);

      for (int i = 0; i < 3; i++) {
        tempDelay.clear();
      }

      ping(500, 1.0);  // play notification (sound effect)

      recordingState = READY_FOR_RECORD;
    }
  }

  // FINISH COMMITTING LAYER
  else if (recordingState == COMMITTING) {
    if (timer >= (commitRecordingStart + LOOP_TIME)) {
      Serial.println("Commit recording stopped");

      outMixer.gain(2, 0.0);  // disable temp delay, fixes double timbre glitch

      // disable temp delay signal into full delay
      // fullDelayMixer.gain(1, 0.0);
      fullRamp.amplitude(0.0, 50);  // turn off signal via ramp, not gate

      // disable temp delay signal feedback
      tempDelayMixer.gain(0, 0.0);

      // clear temp delay (optional)
      for (int i = 0; i < 3; i++) {
        tempDelay.clear();
      }

      // resets the feedback to 1.0 so the loop repeats indefinitely
      // fullDelayMixer.gain(0, 1.0); // already always 1.0 for full delay!

      outMixer.gain(1, 1.0);  // enable full delay output

      // ping(800, 0.3);

      recordingState = READY_FOR_RECORD;
    }
  }
}

void setActiveLoop(int newLoopNum, int oldLoopNum) {
  // set inputs into delay line systems
  fullDelay1Amp.gain(newLoopNum == 0 ? 1.0 : 0.0);
  fullDelay2Amp.gain(newLoopNum == 1 ? 1.0 : 0.0);
  fullDelay3Amp.gain(newLoopNum == 2 ? 1.0 : 0.0);
  fullDelay4Amp.gain(newLoopNum == 3 ? 1.0 : 0.0);

  // disable output of all loops
  for (int i = 0; i < 4; i++) {
    if (!(newLoopNum > -1 && newLoopNum < 4 && i == newLoopNum)) {
      delaySelectNew.gain(i, 0.0);
    };
    delaySelectOld.gain(i, 0.0);
  }

  // return if mute desired
  if (newLoopNum == -1 || newLoopNum > 3) {
    activeLoop = -1;
    return;
  }

  // enable output of new loop ramping up, as well as old loop ramping down
  delaySelectOld.gain(oldLoopNum, 1.0);
  delaySelectNewRamp.amplitude(0.0);
  delaySelectOldRamp.amplitude(1.0);
  delaySelectNew.gain(newLoopNum, 1.0);
  delaySelectOldRamp.amplitude(0.0, 100);
  delaySelectNewRamp.amplitude(1.0, 100);

  activeLoop = newLoopNum;
}

// HELPER FUNCTIONS

// https://forum.arduino.cc/t/arduino-map-function-for-float-values/112888/2
/**
 * @brief mapFloat (no automatic clipping, output can exceed out_min/out_max)
 */
float mapFloat(float x, float in_min, float in_max, float out_min,
               float out_max) {
  return (x - in_min) * (out_max - out_min) / (in_max - in_min) + out_min;
}

// play an audible sound effect as a "notification" for various events
void ping(float freq, float mod) {
  notification.frequency(freq);
  notification.pitchMod(mod);
  notification.noteOn();
}
