Firebird1029/enas344-final/v2.5/effect_delayLoop.cpp

/* Audio Library for Teensy 4.x
 * 
 * Modifications to Houston's effect delaysmooth: https://github.com/houtson/effect_delaysmooth
 * Changed delay_inc parameter to allow < 0.0 values
 * Reverted to original, commented-out version of setting current_delay_float value
 * Added simple delay method to set desired delay with no fade or interpolation
 * 
 * Added ramp mode to change from two delay times using a set rate
 * 
 */
#include "effect_delayLoop.h"

#include <Arduino.h>

void AudioEffectdelayLoop::begin(int16_t *delay_l, uint32_t max_delay_length) {
  delay_line = delay_l;
  max_delay_length_samples = max_delay_length - 1;
  write_index = 0;
  
}

void AudioEffectdelayLoop::clear() {
  for (size_t i = 0; i < max_delay_length_samples; i++)
  {
    delay_line[i] = 0;
  }
}


// activate a tap and/or change time with a fade between old and new time (no clicks), transition time in millis
uint32_t AudioEffectdelayLoop::delayfade(uint8_t channel, float milliseconds, float transition_time) {
  if (channel >= DELAY_NUM_TAPS) return 0;
  if (milliseconds < 0.0) {
    milliseconds = 0.0;
  }
  if (transition_time < 0.0) transition_time = 0.0;

  uint32_t delay_length_samples = millisToSamples(milliseconds);
  if (delay_length_samples > max_delay_length_samples) delay_length_samples = max_delay_length_samples;

  __disable_irq();
  // enable disabled channel
  if (!(activemask & (1 << channel))) {
    // if channel not active then activate and delay as normal, no fade
    tap[channel].fade_to_delay_samples = tap[channel].current_delay = tap[channel].desired_delay = delay_length_samples;
    tap[channel].fade_samples_to_complete_transition = 0;
    activemask |= (1 << channel);
    tap[channel].delay_mode = DELAY_MODE_NORMAL;
  } else {
    // if already active check if currently fading
    if (tap[channel].fade_samples_to_complete_transition == 0) {
      // not currently fading, set up for a expo fade over transition time millis
      tap[channel].fade_to_delay_samples = tap[channel].desired_delay = delay_length_samples;                 // where in the delay are we fading to
      tap[channel].fade_transition_time = transition_time;                                                    // fade over xx milis
      tap[channel].fade_samples_to_complete_transition = millisToSamples(tap[channel].fade_transition_time);  // counter to fade over xx samples
      double tau = -1.0 * transition_time / log(1.0 - 1.0 / 1.01);                                            // calculate a multiplier for a exponential fade (with 1.01 overshoot)
      tap[channel].fade_expo_multiplier = pow(exp(-1.0 / tau), 1.0 / (AUDIO_SAMPLE_RATE_EXACT / 1000.0));
      tap[channel].fade_multiplier_out = 1.0;  // initialise the multiplier to be applied as gain on outgoing tap
      tap[channel].fade_multiplier_in = 0.01;  // initialise the multiplier to be applied as gain on incoming tap
      tap[channel].delay_mode = DELAY_MODE_FADE;
    } else {
      // currently fading, want to let that play out then fade again to desired so set desired as new target
      tap[channel].desired_delay = delay_length_samples;
    }
  }
  __enable_irq();
  return tap[channel].current_delay;
}






//change delay line with no interpolation
uint32_t AudioEffectdelayLoop::delay(uint8_t channel, float milliseconds) {

  if (channel >= DELAY_NUM_TAPS) return 0;
  if (milliseconds < 0.0) {
    milliseconds = 0.0;
  }
   uint32_t delay_length_samples = millisToSamples(milliseconds);

  if (delay_length_samples > max_delay_length_samples) delay_length_samples = max_delay_length_samples;

     __disable_irq();
    tap[channel].fade_to_delay_samples = tap[channel].current_delay = tap[channel].desired_delay = delay_length_samples;
    tap[channel].fade_samples_to_complete_transition = 0;
    activemask |= (1 << channel);
    tap[channel].delay_mode = DELAY_MODE_NORMAL;
     __enable_irq();
     
   return tap[channel].current_delay;
}







// this is the smoothed version from houston's original 10tap object

uint32_t AudioEffectdelayLoop::delaysmooth(uint8_t channel, float milliseconds, float _inc) {
  if (channel >= DELAY_NUM_TAPS) return 0;
  if (milliseconds < 0.0) milliseconds = 0.0;
    tap[channel].delay_inc = _inc/100000.0;
  if (tap[channel].delay_inc < DELAY_INC)
    tap[channel].delay_inc = DELAY_INC;
    
  uint32_t delay_length_samples = millisToSamples(milliseconds);
  if (delay_length_samples > max_delay_length_samples) delay_length_samples = max_delay_length_samples;

  __disable_irq();
  // enable disabled channel
  if (!(activemask & (1 << channel))) {
    // if not previously activie just move straight to it
    tap[channel].current_delay = tap[channel].desired_delay = delay_length_samples;
    activemask |= (1 << channel);
  } else {
    // if already active...set desired
    tap[channel].desired_delay = delay_length_samples;
    if (tap[channel].current_delay != tap[channel].desired_delay) {
      tap[channel].current_delay_float = tap[channel].current_delay;
      tap[channel].last_sample = 0;
      tap[channel].delay_mode = DELAY_MODE_SMOOTH;
    } else {
      // already at desired
      tap[channel].delay_mode = DELAY_MODE_NORMAL;
    }
  }
  __enable_irq();
  return tap[channel].current_delay;
}





// this function sets the current and desired delay times at the same time and a ramp rate
uint32_t AudioEffectdelayLoop::delayramp(uint8_t channel, float s_milliseconds, float e_milliseconds, float _inc) {
  if (channel >= DELAY_NUM_TAPS) return 0;
  if (s_milliseconds < 0.0) s_milliseconds = 0.0;
  if (e_milliseconds < 0.0) e_milliseconds = 0.0;
  tap[channel].delay_ramp = _inc - 1.0;

  uint32_t s_delay_length_samples = millisToSamples(s_milliseconds);
  uint32_t e_delay_length_samples = millisToSamples(e_milliseconds);
  if (s_delay_length_samples > max_delay_length_samples) s_delay_length_samples = max_delay_length_samples;
  if (e_delay_length_samples > max_delay_length_samples) e_delay_length_samples = max_delay_length_samples;

  __disable_irq();
  // enable disabled channel
  if (!(activemask & (1 << channel))) {
    // if not previously activie just move straight to it
    tap[channel].current_delay = tap[channel].desired_delay = e_delay_length_samples;
    activemask |= (1 << channel);
  } else {
    // if already active...set desired
    tap[channel].current_delay = s_delay_length_samples;
    tap[channel].desired_delay = e_delay_length_samples;
    if (tap[channel].current_delay != tap[channel].desired_delay) {
      tap[channel].current_delay_float = tap[channel].current_delay;
      tap[channel].last_sample = 0;
      tap[channel].delay_mode = DELAY_MODE_RAMP;
    } else {
      // already at desired
      tap[channel].delay_mode = DELAY_MODE_NORMAL;
    }
  }
  __enable_irq();
  return tap[channel].current_delay;
}

void AudioEffectdelayLoop::disable(uint8_t channel) {
  if (channel >= DELAY_NUM_TAPS) return;
  // disable this channel
  activemask &= ~(1 << channel);
};




void AudioEffectdelayLoop::update(void) {
  audio_block_t *input, *output;
  int16_t *input_data_pointer, *output_data_pointer;
  uint32_t read_index, start_index;
  uint32_t fade_to_read_index = 0;
  uint8_t channel;

  int16_t next_sample = 0;
  int16_t sample = 0;

  if (delay_line == NULL) return;
  // reading and wriitng the block separately so grab a copy of the write_index starting poisition
  start_index = write_index;

  // write incoming block of samples to buffer if not freezing buffer
  input = receiveReadOnly();
  if (input) {
    if (!freezeBuffer) {
      input_data_pointer = input->data;
      for (int i = 0; i < AUDIO_BLOCK_SAMPLES; i++) {
        delay_line[write_index++] = *input_data_pointer++;
        if (write_index >= max_delay_length_samples) write_index = 0;
      }
    } else {
      // if buffer frozen move write index on a block
//      write_index += AUDIO_BLOCK_SAMPLES;
//      if (write_index >= max_delay_length_samples) write_index = (write_index + max_delay_length_samples) % max_delay_length_samples;
   
      write_index += AUDIO_BLOCK_SAMPLES;
      if (write_index >= loopMax_samples) write_index = loopMin_samples;

    }
    release(input);
  }

  // delay
  // process each tap and write out delayed samples
  for (channel = 0; channel < DELAY_NUM_TAPS; channel++) {
    // check if channel is active
    if (!(activemask & (1 << channel))) continue;
    output = allocate();
    if (!output) continue;
    output_data_pointer = output->data;

    // if fading between current delay to desired , position desired read head
    if (tap[channel].delay_mode == DELAY_MODE_FADE) fade_to_read_index = ((start_index - tap[channel].fade_to_delay_samples + max_delay_length_samples) % max_delay_length_samples);

    // position the main read head (current_delay_) for this channel / tap
    read_index = ((start_index - tap[channel].current_delay + max_delay_length_samples) % max_delay_length_samples);

    // process each sample in the audio block
    for (int i = 0; i < AUDIO_BLOCK_SAMPLES; i++) {
      //
      // if fading, cross mix in fade_length_samples steps
      //
      if (tap[channel].delay_mode == DELAY_MODE_FADE) {
        // update the fade multiplier for expo fade curves
        tap[channel].fade_multiplier_out *= tap[channel].fade_expo_multiplier;
        tap[channel].fade_multiplier_in /= tap[channel].fade_expo_multiplier;
        // read the two points from the delay line, crossfade and send to the output block
        *output_data_pointer++ = (int16_t)(delay_line[read_index] * tap[channel].fade_multiplier_out) + (int16_t)(delay_line[fade_to_read_index] * tap[channel].fade_multiplier_in);
        tap[channel].fade_samples_to_complete_transition--;
        if (tap[channel].fade_samples_to_complete_transition == 0) {  // got to end of fade
          // make the current_delay the fade_to_
          tap[channel].current_delay = tap[channel].fade_to_delay_samples;
          read_index = fade_to_read_index;
          tap[channel].delay_mode = DELAY_MODE_NORMAL;
          // if stil not at desired delay then start another fade to it
          if (tap[channel].desired_delay != tap[channel].current_delay) {
            tap[channel].fade_to_delay_samples = tap[channel].desired_delay;
            tap[channel].fade_samples_to_complete_transition = millisToSamples(tap[channel].fade_transition_time);  // counter to fade over xx samples
            fade_to_read_index = ((start_index - tap[channel].fade_to_delay_samples + max_delay_length_samples) % max_delay_length_samples);
            // re-set fade multipliers
            tap[channel].fade_multiplier_out = 1.0;  // initialise the multiplier to be applied as gain on outgoing tap
            tap[channel].fade_multiplier_in = 0.01;  // initialise the multiplier to               be applied as gain on incoming tap
            tap[channel].delay_mode = DELAY_MODE_FADE;
          }
        }
        // increment and wrap around the fade_to_read_index
        fade_to_read_index++;
        if (fade_to_read_index >= max_delay_length_samples) fade_to_read_index = 0;
      }
      //
      // Ramping from one delay to another
      //
      if (tap[channel].delay_mode == DELAY_MODE_RAMP) {

        tap[channel].current_delay_float = tap[channel].current_delay_float - tap[channel].delay_ramp;
        
        tap[channel].current_delay = static_cast<int32_t>(tap[channel].current_delay_float);
        // check if reached desired delay
        if (abs(tap[channel].current_delay_float - tap[channel].desired_delay) < 1) {
          tap[channel].current_delay = tap[channel].desired_delay;
          //Serial.print("=\n");
          // reached desire delay, re-position index and change to normal delay
          
          read_index = ((start_index + i - tap[channel].current_delay + max_delay_length_samples) % max_delay_length_samples);
          tap[channel].delay_mode = DELAY_MODE_NORMAL;
       
        } else {
          // not reached desired yet so get next sample and interpolate
          // Serial.print(".");
          // Serial.printf("Cur:%d Des:%d Flt:%.9f\n", tap[channel].current_delay, tap[channel].desired_delay, tap[channel].current_delay_float);
          int sample_idx = (start_index + i - tap[channel].current_delay + max_delay_length_samples) % max_delay_length_samples;
          int next_idx = (start_index + i - (tap[channel].current_delay + 1) + max_delay_length_samples) % max_delay_length_samples;
          // Serial.printf("S_idx:%d N_idx:%d\n", sample_idx, next_idx);
          sample = delay_line[sample_idx];
          next_sample = delay_line[next_idx];
          // sample = delay_line[(read_index - tap[channel].current_delay + max_delay_length_samples) % max_delay_length_samples];
          // next_sample = delay_line[(read_index - (tap[channel].current_delay + 1) + max_delay_length_samples) % max_delay_length_samples];
          if (tap[channel].last_sample == 0) tap[channel].last_sample = sample;  // if just starting help the allpass tune in quickly
          *output_data_pointer++ = tap[channel].last_sample =
              allPassInterpolSamples(sample, next_sample, tap[channel].last_sample, abs(tap[channel].current_delay_float - tap[channel].current_delay));
        }
      }
      // smooth transition from one delay time to another
      //
      if (tap[channel].delay_mode == DELAY_MODE_SMOOTH) {
        // move the delay time by a small increment (DELAY_INC), split into numbers of sample + frac
        tap[channel].current_delay_float = tap[channel].current_delay_float + tap[channel].delay_inc * static_cast<double>(tap[channel].desired_delay - tap[channel].current_delay_float);
//        if (tap[channel].current_delay > tap[channel].desired_delay){
//          tap[channel].current_delay_float = tap[channel].current_delay_float - delay_inc;
//        }else {
//          tap[channel].current_delay_float = tap[channel].current_delay_float + delay_inc;
//        }
        tap[channel].current_delay = static_cast<int32_t>(tap[channel].current_delay_float);
        // check if reached desired delay
        if (abs(tap[channel].current_delay_float - tap[channel].desired_delay) < 1) {
          tap[channel].current_delay = tap[channel].desired_delay;
          //Serial.print("=\n");
          // reached desire delay, re-position index and change to normal delay
          read_index = ((start_index + i - tap[channel].current_delay + max_delay_length_samples) % max_delay_length_samples);
          tap[channel].delay_mode = DELAY_MODE_NORMAL;
        } else {
          // not reached desired yet so get next sample and interpolate
          // Serial.print(".");
          // Serial.printf("Cur:%d Des:%d Flt:%.9f\n", tap[channel].current_delay, tap[channel].desired_delay, tap[channel].current_delay_float);
          int sample_idx = (start_index + i - tap[channel].current_delay + max_delay_length_samples) % max_delay_length_samples;
          int next_idx = (start_index + i - (tap[channel].current_delay + 1) + max_delay_length_samples) % max_delay_length_samples;
          // Serial.printf("S_idx:%d N_idx:%d\n", sample_idx, next_idx);
          sample = delay_line[sample_idx];
          next_sample = delay_line[next_idx];
          // sample = delay_line[(read_index - tap[channel].current_delay + max_delay_length_samples) % max_delay_length_samples];
          // next_sample = delay_line[(read_index - (tap[channel].current_delay + 1) + max_delay_length_samples) % max_delay_length_samples];
          if (tap[channel].last_sample == 0) tap[channel].last_sample = sample;  // if just starting help the allpass tune in quickly
          *output_data_pointer++ = tap[channel].last_sample =
              allPassInterpolSamples(sample, next_sample, tap[channel].last_sample, abs(tap[channel].current_delay_float - tap[channel].current_delay));
        }
      }


      
      //
      // normal delay
      //
      if (tap[channel].delay_mode == DELAY_MODE_NORMAL) {
        // read delay line and send sample to the output block
        *output_data_pointer++ = delay_line[read_index];
      }
      // increment and wrap around the  read index
      read_index++;
      if (read_index >= max_delay_length_samples) read_index = 0;
    }
    transmit(output, channel);
    release(output);
  }
  // if (dump_samples) dump_samples = false;
}

// set the increment for the smooth delay
void AudioEffectdelayLoop::setDelayIncPerSample(uint8_t channel, float _DELAYINC){
    /*tap[channel].inc_per_sample = _DELAYINC;
    if (tap[channel].inc_per_sample < 0.1) tap[channel].inc_per_sample = 0.1;
    if (tap[channel].inc_per_sample > 1.0) tap[channel].inc_per_sample = 1.0;*/
};

float AudioEffectdelayLoop::getWrite(void){

//  float out = (float) (max_delay_length_samples / write_index);
  float out = (float) write_index / max_delay_length_samples;
  return out;
};

float AudioEffectdelayLoop::getMillis(uint8_t channel){

  float out = tap[channel].current_delay / 44.1;
  return out;
};

float AudioEffectdelayLoop::getOffset(uint8_t channel){

  float out = (float)((write_index - tap[channel].current_delay + max_delay_length_samples) % max_delay_length_samples) / max_delay_length_samples;
  return out;
};
