Firebird1029/enas344-final/(commit log)

2023-04-04 add VSCode Arduino extension files
2023-04-11 add 4" box laser cut svg
2023-04-11 add working sketch with ladder filter with old GY521 library
2023-04-16 fix undefined identifiers error by using Arduino VS Code extension
2023-04-17 v1.1.1 WORKING: added envelope to ribbon pot, refactored to camel case
2023-04-17 VSCode setup: add Arduino build output folder
2023-04-17 v2.0 WIP: duplicate v1.1.1, comment out MPU6050 code, update ribbon pin
2023-04-17 WIP working w/ bug: add looper global vars
    [v2.0.ino]
2023-04-17 rename v1.1.2 and v1.1.3 to broken
    [v1.1.2_broken.ino, v1.1.3_broken.ino]
2023-04-18 v2 working: add MPU code back, add clear button
2023-04-18 patch v2.0, v2.1: prevent clear race condition
    [v2.0.ino]
2023-04-18 v2.1 working: add vibrato based on pitch
2023-04-19 v2.2 working encoder + encoder button
2023-04-23 re-calibrate softpot 10k resistors
2023-04-25 working OLED + encoder menu functionality
2023-04-25 v2.2 working: update const values to soldered version
2023-04-25 v2.2: leftover loop fix attempts, disable push buttons
2023-04-25 correct encoder clockwise
2023-04-25 v2.3 working: fix pitch read bugs
2023-04-25 v2.3 add Larry's gyro fix
    [basic_readings_fusion_v2.ino]
2023-04-25 v2.3: add Jiacheng's gyro fix
2023-04-30 add Konrad's percussion samples
2023-05-02 v2.5 working: fix percussion indexing
    [v2.5.ino]
2023-05-02 v2.5 messy: chord fix
    [v2.5.ino]
2023-05-10 add all documentation and pictures
    [final_cardboard_box.dwg]
